quockhanh0921605790-pixel/AutoSoap-CPM/README.md

# AutoSoap-CPM (COLD PROCESS METHOD)
[NCKH-2026]

Code gần hoàn thiện. Tiến độ: ========== [100%]
Lưu ý phải upload toàn bộ file .ino để hoạt động.

[MCU: ESP32-S3-N16R8]

----------------------------------
CODE SẮP TỚI:

-WEBSERVER-
