quockhanh0921605790-pixel/AutoSoap-CPM/AUTOSOAPCPM_V2.stl

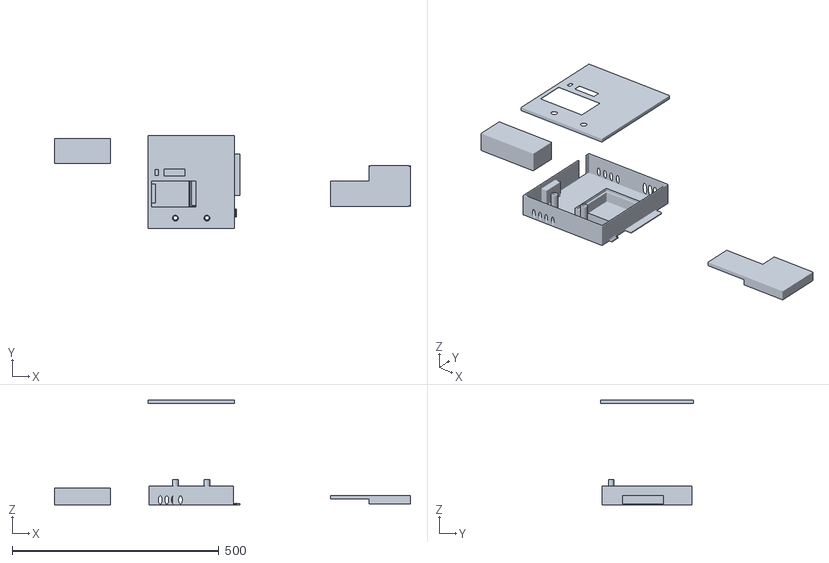
[picture p14: CAD file, 2026-10-04]
AUTOSOAPCPM_V2.stl
860.8 x 224.0 x 252.8
