quockhanh0921605790-pixel/AutoSoap-CPM/(commit log)

2026-09-30 Mã nguồn cho autosoap cpm mới nhất (30/9/2026)
2026-10-04 Add files via upload
    bản in 3D máy dòng v2
    [AUTOSOAPCPM_V2.stl]
2026-10-04 Đề cương nghiên cứu khoa học 2026 - 2027
